jwood5063/wall-e/hardware/pico-carrier/manager-3.kicad_sch

## KiCad design hardware/pico-carrier/manager-3.kicad_sch (2026-11-06)

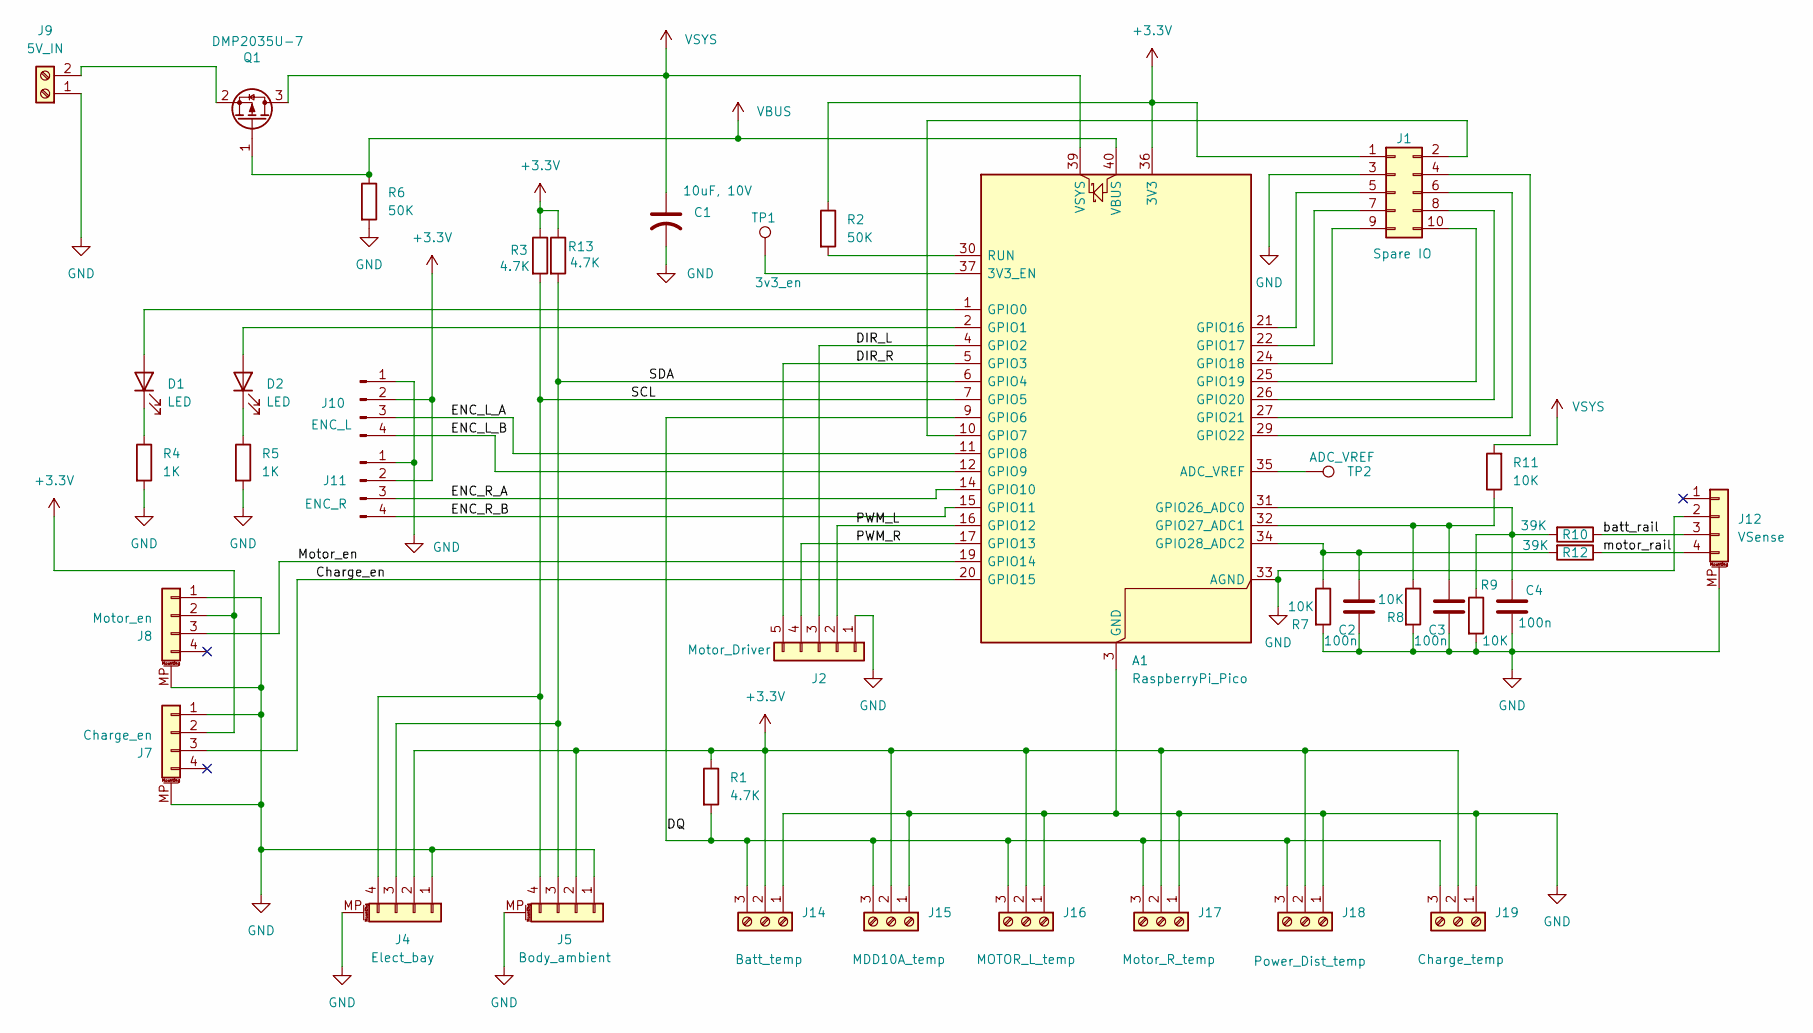
[picture p2: schematic manager-3.kicad_sch]

Parts:
A1: RaspberryPi_Pico; RaspberryPi_Pico_Common_THT
C1: 10uF, 10V; C_Radial_D4.0mm_H5.0mm_P1.50mm
C2, C3, C4: 100n; C_Disc_D5.0mm_W2.5mm_P2.50mm
D1, D2: LED; LED_D5.0mm
J1: Spare IO; IDC-Header_2x05_P2.54mm_Vertical
J2: Motor_Driver; Molex_KK-254_AE-6410-05A_1x05_P2.54mm_Vertical
J4: Elect_bay; JST_SH_SM04B-SRSS-TB_1x04-1MP_P1.00mm_Horizontal
J5: Body_ambient; JST_SH_SM04B-SRSS-TB_1x04-1MP_P1.00mm_Horizontal
J7: Charge_en; JST_SH_SM04B-SRSS-TB_1x04-1MP_P1.00mm_Horizontal
J8: Motor_en; JST_SH_SM04B-SRSS-TB_1x04-1MP_P1.00mm_Horizontal
J9: 5V_IN; TerminalBlock_RND_205-00012_1x02_P5.00mm_Horizontal
J10: ENC_L; JST_PH_S4B-PH-K_1x04_P2.00mm_Horizontal
J11: ENC_R; JST_PH_S4B-PH-K_1x04_P2.00mm_Horizontal
J12: VSense; JST_SH_SM04B-SRSS-TB_1x04-1MP_P1.00mm_Horizontal
J14: Batt_temp; TerminalBlock_RND_205-00002_1x03_P5.00mm_Horizontal
J15: MDD10A_temp; TerminalBlock_RND_205-00002_1x03_P5.00mm_Horizontal
J16: MOTOR_L_temp; TerminalBlock_RND_205-00002_1x03_P5.00mm_Horizontal
J17: Motor_R_temp; TerminalBlock_RND_205-00002_1x03_P5.00mm_Horizontal
J18: Power_Dist_temp; TerminalBlock_RND_205-00002_1x03_P5.00mm_Horizontal
J19: Charge_temp; TerminalBlock_RND_205-00002_1x03_P5.00mm_Horizontal
Q1: DMP2035U-7; SOT-23
R1, R3, R13: 4.7K; R_Axial_DIN0207_L6.3mm_D2.5mm_P10.16mm_Horizontal
R2, R6: 50K; R_Axial_DIN0207_L6.3mm_D2.5mm_P10.16mm_Horizontal
R4, R5: 1K; R_Axial_DIN0207_L6.3mm_D2.5mm_P10.16mm_Horizontal
R7, R8, R9, R11: 10K; R_Axial_DIN0207_L6.3mm_D2.5mm_P10.16mm_Horizontal
R10, R12: 39K; R_Axial_DIN0207_L6.3mm_D2.5mm_P10.16mm_Horizontal
TP1: 3v3_en; PinHeader_1x01_P2.54mm_Vertical
TP2: ADC_VREF; PinHeader_1x01_P2.54mm_Vertical

Connections:
+3.3V: A1.36 (3V3), J1.1, J4.2, J5.2, J7.2, J8.2, J10.2, J11.2, J14.2, J15.2, J16.2, J17.2, J18.2, J19.2, R1.1, R2.1, R3.1, R13.1
Charge_en: A1.20 (GPIO15), J7.3
DIR_L: A1.4 (GPIO2), J2.3
DIR_R: A1.5 (GPIO3), J2.5
DQ: A1.9 (GPIO6), J14.3, J15.3, J16.3, J17.3, J18.3, J19.3, R1.2
ENC_L_A: A1.11 (GPIO8), J10.3
ENC_L_B: A1.12 (GPIO9), J10.4
ENC_R_A: A1.14 (GPIO10), J11.3
ENC_R_B: A1.15 (GPIO11), J11.4
GND: A1.3 (GND), A1.8 (GND), A1.13 (GND), A1.18 (GND), A1.23 (GND), A1.28 (GND), A1.33 (AGND), A1.38 (GND), C1.2, C2.2, C3.2, C4.2, J1.3, J2.1, J4.1, J4.MP (MountPin), J5.1, J5.MP (MountPin), J7.1, J7.MP (MountPin), J8.1, J8.MP (MountPin), J9.1, J10.1, J11.1, J12.2, J12.MP (MountPin), J14.1, J15.1, J16.1, J17.1, J18.1, J19.1, R4.2, R5.2, R6.2, R7.2, R8.2, R9.2
Motor_en: A1.19 (GPIO14), J8.3
unnamed: A1.1 (GPIO0), D1.2 (A)
unnamed: A1.2 (GPIO1), D2.2 (A)
unnamed: A1.10 (GPIO7), J1.2
unnamed: A1.21 (GPIO16), J1.5
unnamed: A1.22 (GPIO17), J1.7
unnamed: A1.24 (GPIO18), J1.9
unnamed: A1.25 (GPIO19), J1.10
unnamed: A1.26 (GPIO20), J1.8
unnamed: A1.27 (GPIO21), J1.6
unnamed: A1.29 (GPIO22), J1.4
unnamed: A1.30 (RUN), R2.2
unnamed: A1.31 (GPIO26_ADC0), C4.1, R9.1, R10.2
unnamed: A1.32 (GPIO27_ADC1), C3.1, R8.1, R11.1
unnamed: A1.34 (GPIO28_ADC2), C2.1, R7.1, R12.2
unnamed: A1.35 (ADC_VREF), TP2.1
unnamed: A1.37 (3V3_EN), TP1.1
unnamed: D1.1 (K), R4.1
unnamed: D2.1 (K), R5.1
unnamed: J9.2, Q1.2 (S)
PWM_L: A1.16 (GPIO12), J2.2
PWM_R: A1.17 (GPIO13), J2.4
SCL: A1.7 (GPIO5), J4.4, J5.4, R3.2
SDA: A1.6 (GPIO4), J4.3, J5.3, R13.2
VBUS: A1.40 (VBUS), Q1.1 (G), R6.1
VSYS: A1.39 (VSYS), C1.1, Q1.3 (D), R11.2
batt_rail: J12.3, R10.1
motor_rail: J12.4, R12.1
