jwood5063/wall-e/(commit log)

2026-11-06 Initial Wall-E project contents
    README with architecture and 2026-11-06 status, build plan (public copy),
    weight budget, charging-dock build page, voice-client parts spec, target
    render, ESP32-S3 arm test sketch, Pico sequencer notes, Pico carrier
    KiCad schematic, and placeholders for the Pi/Pico-resident code.
    [manager-3.kicad_sch, wall-e-weight-budget.csv]
2026-11-10 power sequencing
